HAW-Hatim/FPGA-Audio-Beamforming/Block diagrams/Address_counter.jpg

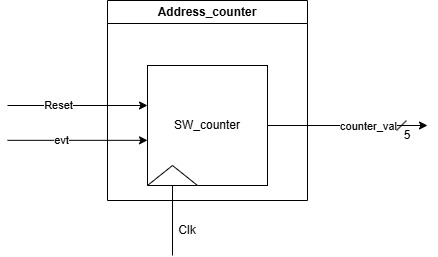
Block diagrams/Address_counter.jpg
