HAW-Hatim/FPGA-Audio-Beamforming/Block diagrams/Angle_To_Delay (1).jpg

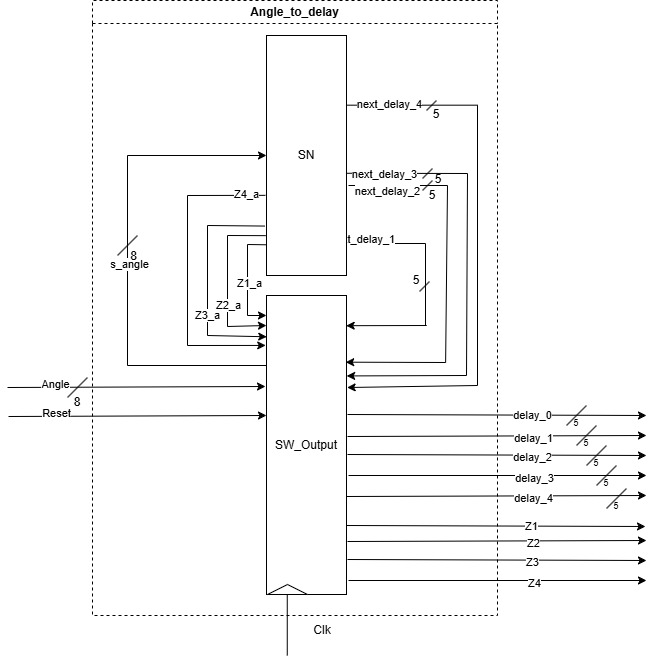
Block diagrams/Angle_To_Delay (1).jpg
