HAW-Hatim/FPGA-Audio-Beamforming/Block diagrams/Angle_To_Delay.jpg

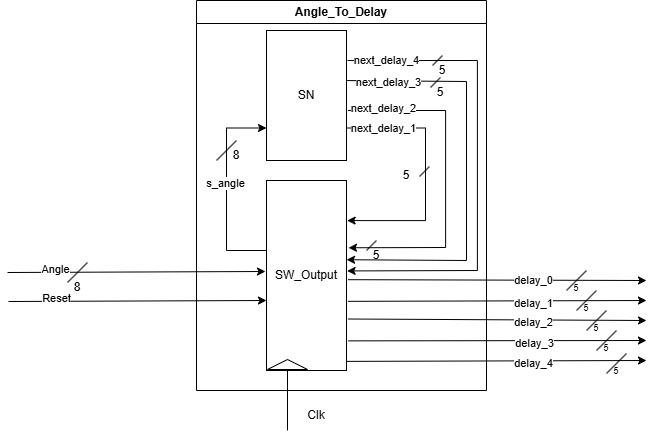
Block diagrams/Angle_To_Delay.jpg
