HAW-Hatim/FPGA-Audio-Beamforming/Block diagrams/BRAM (2).jpg

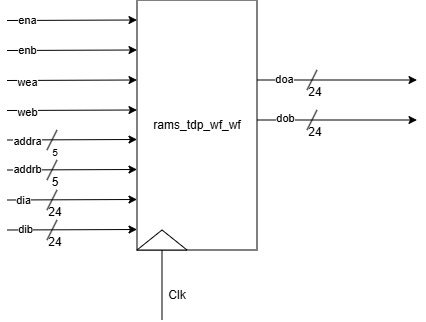
Block diagrams/BRAM (2).jpg
