HAW-Hatim/FPGA-Audio-Beamforming/Block diagrams/DAS_Blockdiagram (2).jpg

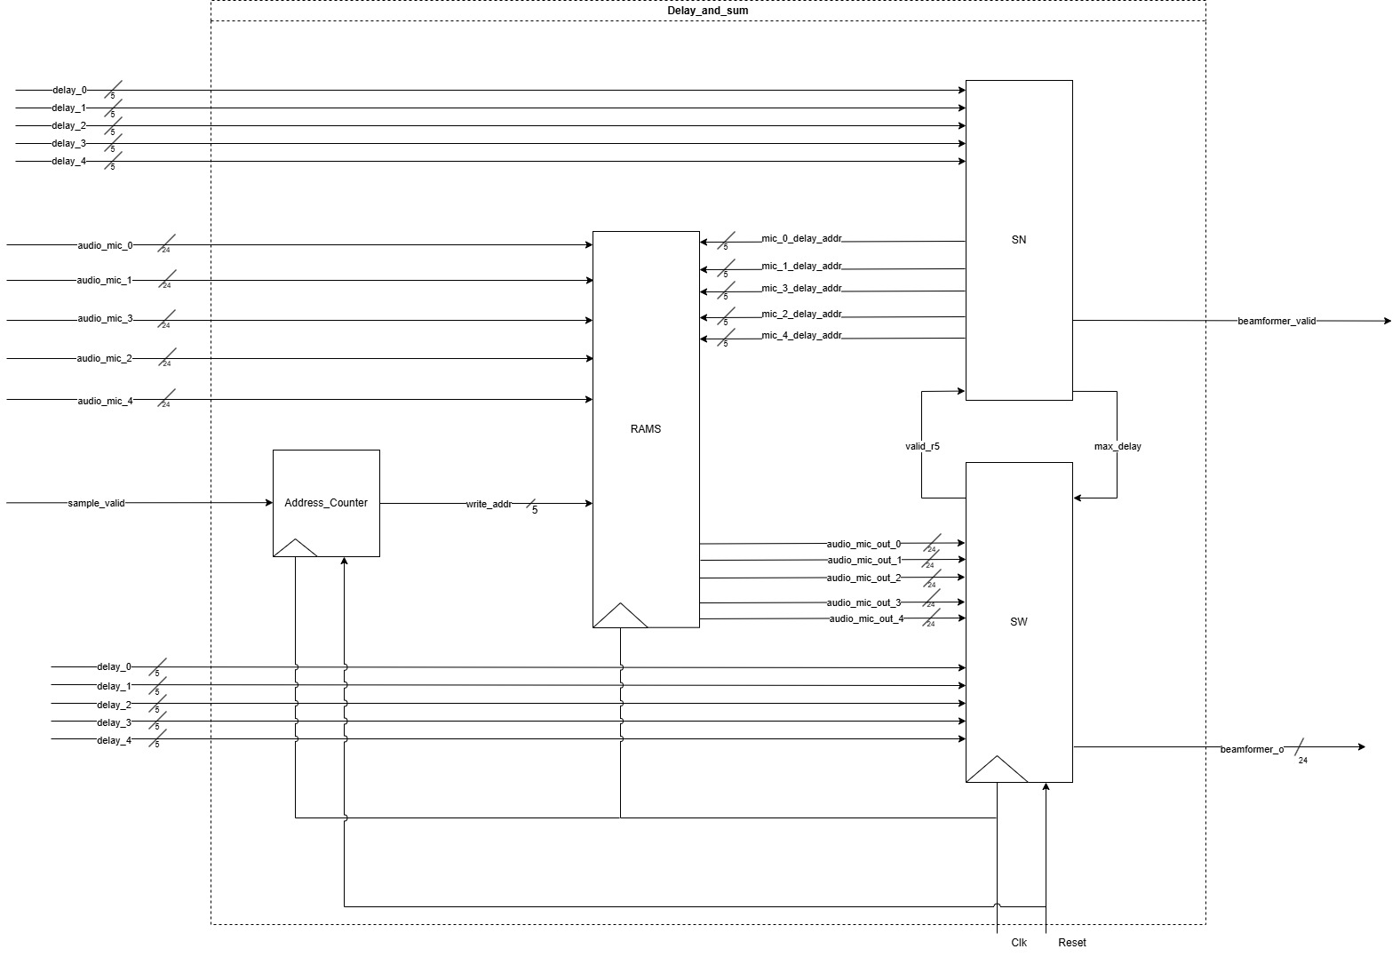
Block diagrams/DAS_Blockdiagram (2).jpg
