HAW-Hatim/FPGA-Audio-Beamforming/Block diagrams/DY_Final (1)-Seite-6.jpg

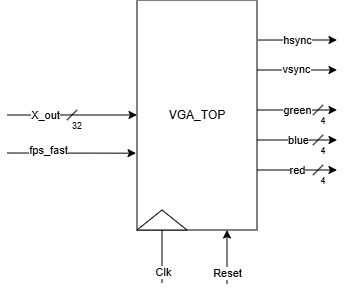
Block diagrams/DY_Final (1)-Seite-6.jpg
