HAW-Hatim/FPGA-Audio-Beamforming/Block diagrams/DY_Final-FFT32.jpg

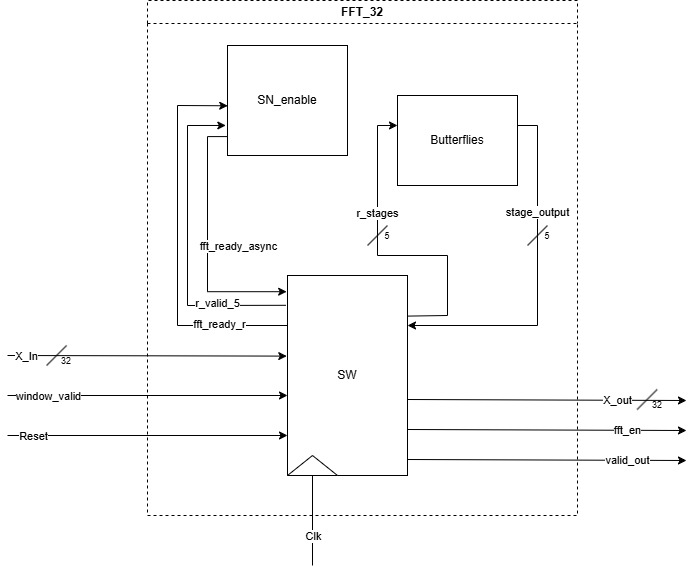
Block diagrams/DY_Final-FFT32.jpg
