HAW-Hatim/FPGA-Audio-Beamforming/Block diagrams/DY_Final-FFT_TOP.jpg

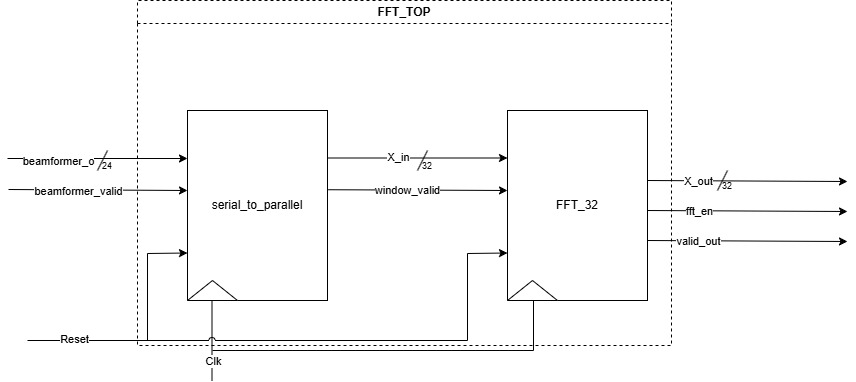
Block diagrams/DY_Final-FFT_TOP.jpg
