HAW-Hatim/FPGA-Audio-Beamforming/Block diagrams/DY_Final-FSM_S2p (1).jpg

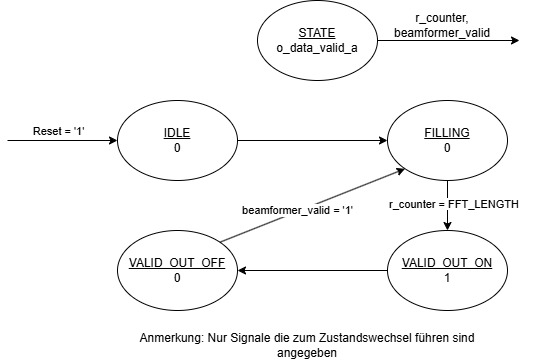
Block diagrams/DY_Final-FSM_S2p (1).jpg
