HAW-Hatim/FPGA-Audio-Beamforming/Block diagrams/DY_Final-S2P.jpg

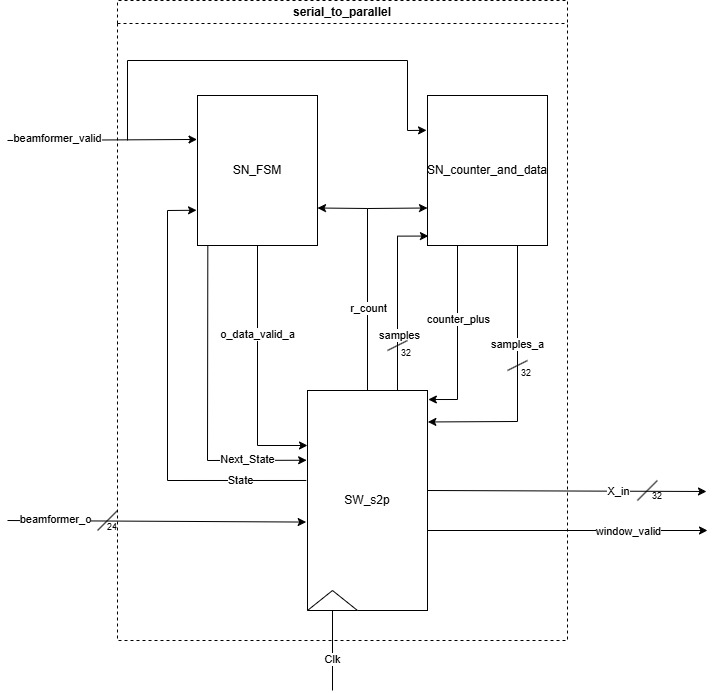
Block diagrams/DY_Final-S2P.jpg
