HAW-Hatim/FPGA-Audio-Beamforming/Block diagrams/i2s_rx.png

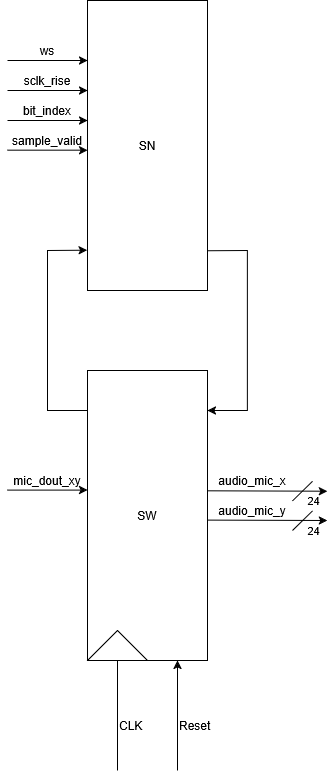
Block diagrams/i2s_rx.png
