HAW-Hatim/FPGA-Audio-Beamforming/Block diagrams/i2s_timing.png

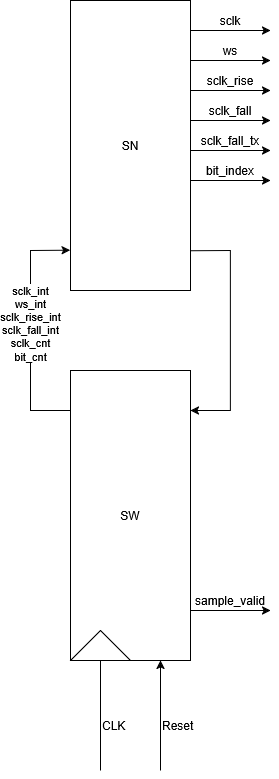
Block diagrams/i2s_timing.png
