HAW-Hatim/FPGA-Audio-Beamforming/Block diagrams/i2s_top.png

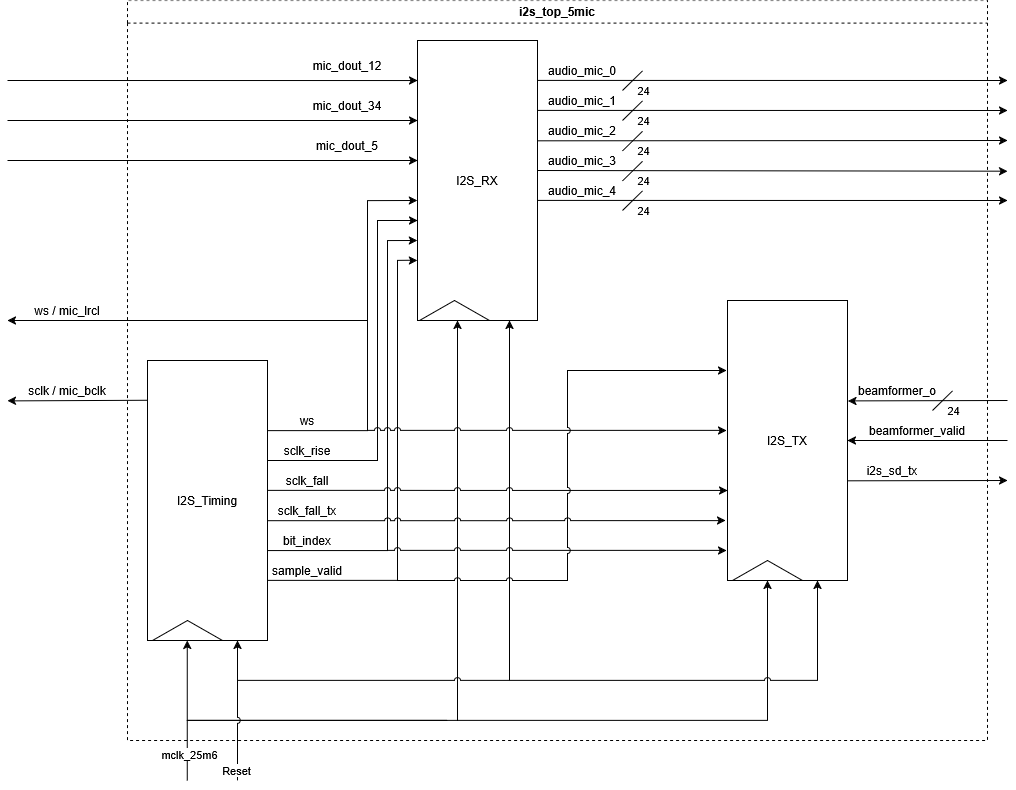
Block diagrams/i2s_top.png
