HAW-Hatim/FPGA-Audio-Beamforming/Block diagrams/i2s_tx.png

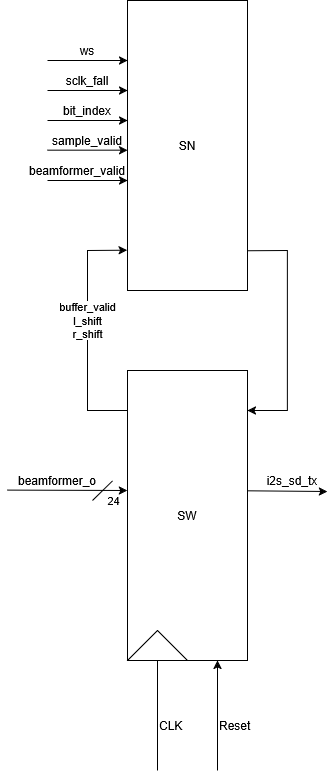
Block diagrams/i2s_tx.png
