HAW-Hatim/FPGA-Audio-Beamforming/Block diagrams/RAMS_Blockdiagram (3).jpg

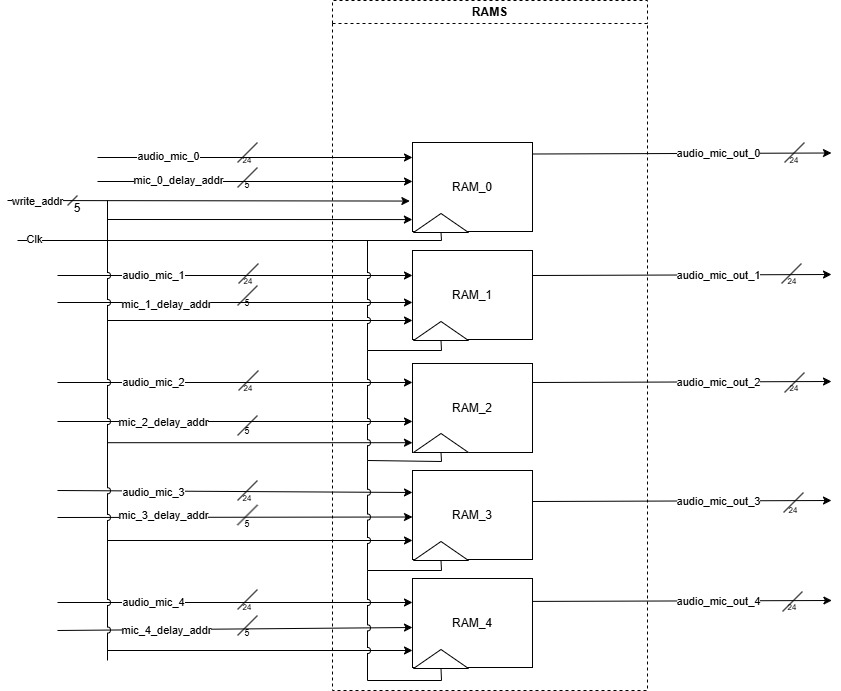
Block diagrams/RAMS_Blockdiagram (3).jpg
