HAW-Hatim/FPGA-Audio-Beamforming/Block diagrams/Seven_segment_disp.png

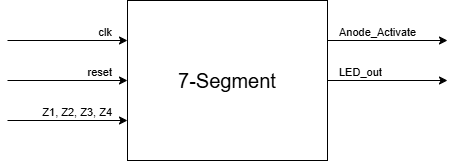
Block diagrams/Seven_segment_disp.png
