HAW-Hatim/FPGA-Audio-Beamforming/Results/1_5khz_30cm_90deg_to_minus90deg.jpg

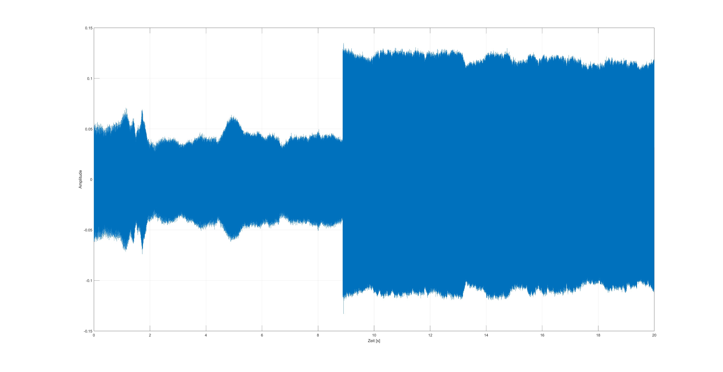
Results/1_5khz_30cm_90deg_to_minus90deg.jpg
