HAW-Hatim/FPGA-Audio-Beamforming/Results/1_5khz_30cm_minus90deg_to_0deg.jpg

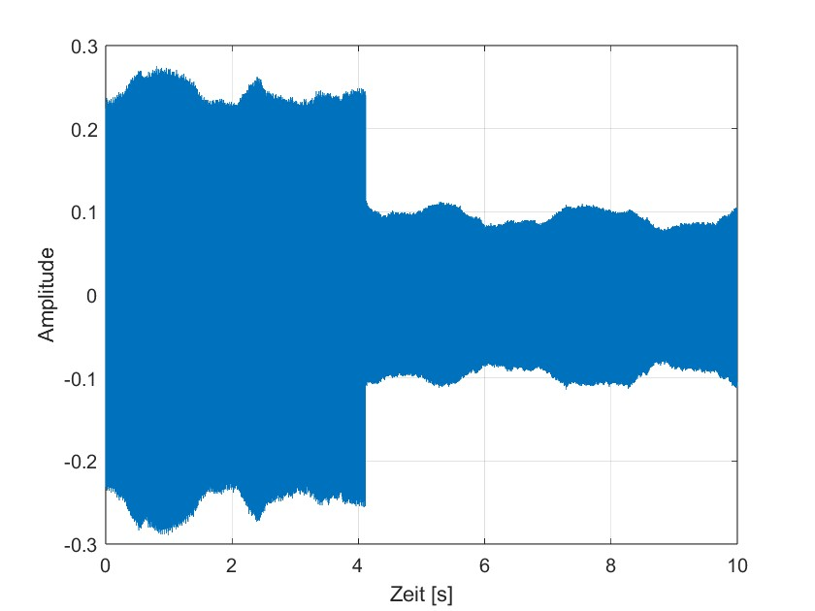
Results/1_5khz_30cm_minus90deg_to_0deg.jpg
