HAW-Hatim/FPGA-Audio-Beamforming/Results/4khz_30cm_90deg_to_minus90deg.jpg

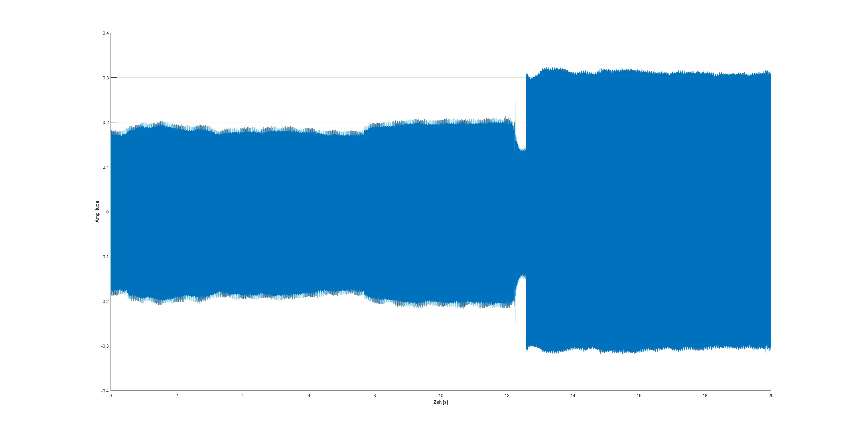
Results/4khz_30cm_90deg_to_minus90deg.jpg
