HAW-Hatim/FPGA-Audio-Beamforming/Results/Simulation/Simu_All.jpg

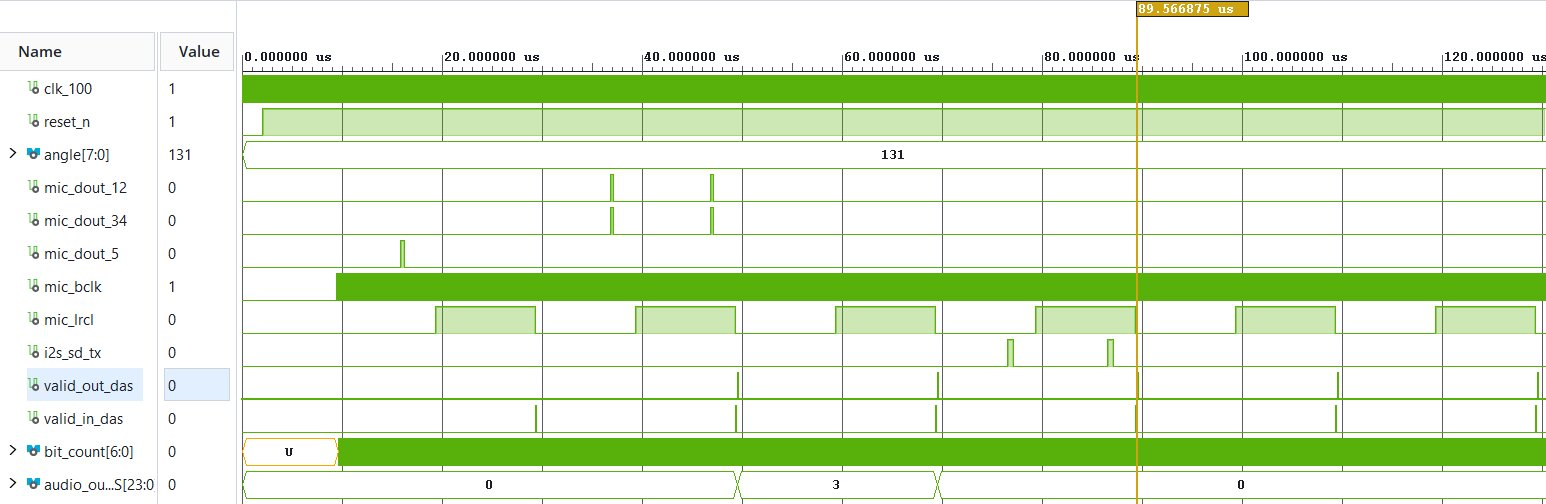
Results/Simulation/Simu_All.jpg
