HAW-Hatim/FPGA-Audio-Beamforming/Results/Simulation/Simu_All.png

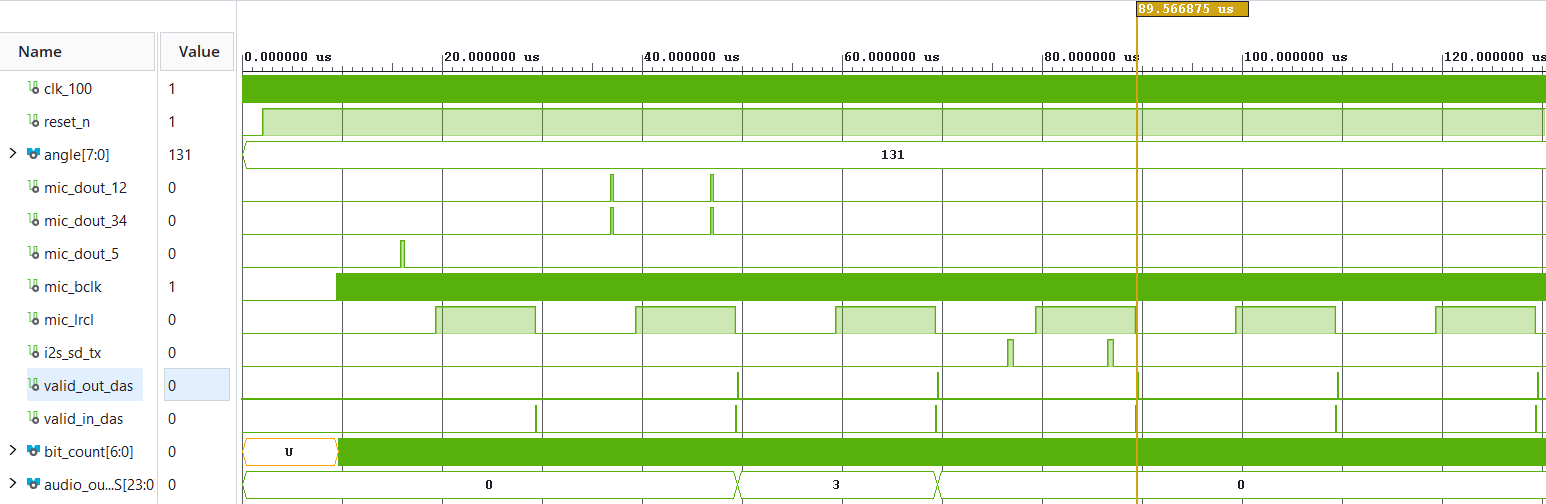
Results/Simulation/Simu_All.png
