HAW-Hatim/FPGA-Audio-Beamforming/Results/Simulation/simu_valid_behavior.png

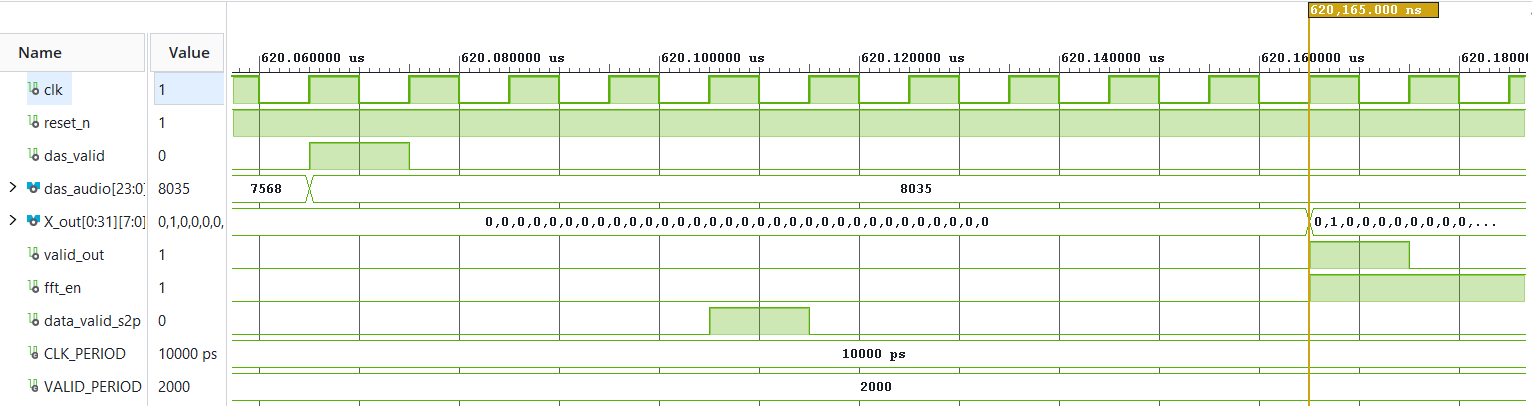
Results/Simulation/simu_valid_behavior.png
