HAW-Hatim/FPGA-Audio-Beamforming/Results/Simulation/Valid_out.png

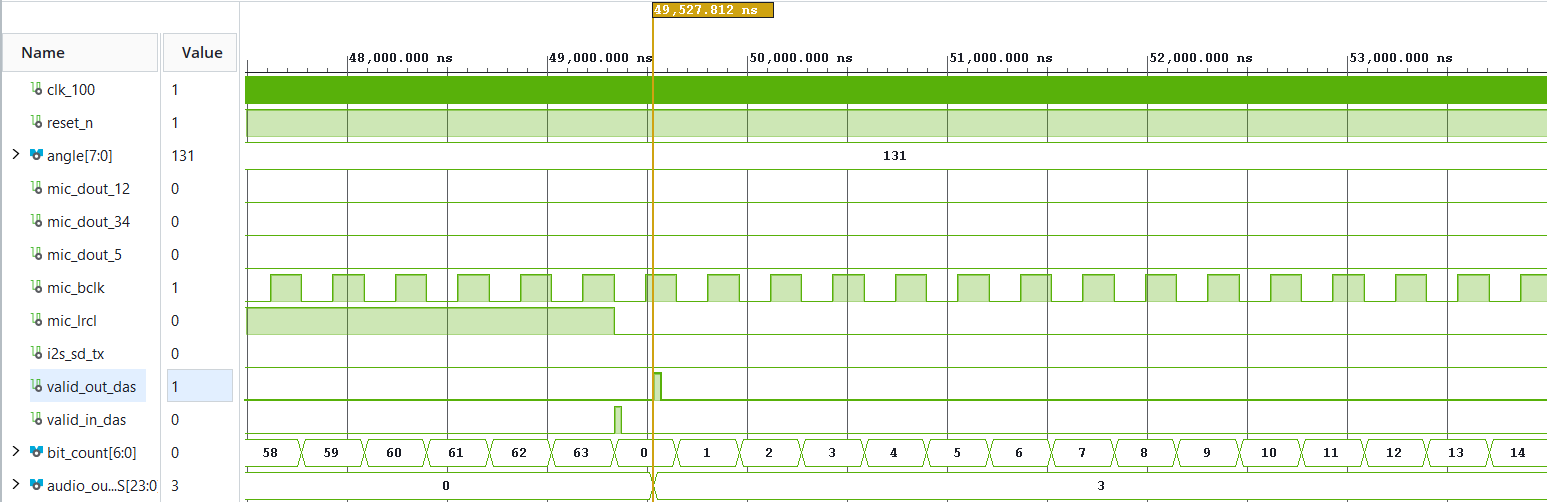
Results/Simulation/Valid_out.png
