HAW-Hatim/FPGA-Audio-Beamforming/Sources/new/Angle_to_delay.vhd

library IEEE;
use IEEE.STD_LOGIC_1164.ALL;

-- Uncomment the following library declaration if using
-- arithmetic functions with Signed or Unsigned values
use IEEE.NUMERIC_STD.ALL;

-- Uncomment the following library declaration if instantiating
-- any Xilinx leaf cells in this code.
--library UNISIM;
--use UNISIM.VComponents.all;

entity Angle_to_delay is
    Port ( Clk : in STD_LOGIC;
           Angle : in STD_LOGIC_VECTOR (7 downto 0);
           delay_0 : out STD_LOGIC_VECTOR (4 downto 0);
           delay_1 : out STD_LOGIC_VECTOR (4 downto 0);
           delay_2 : out STD_LOGIC_VECTOR (4 downto 0);
           delay_3 : out STD_LOGIC_VECTOR (4 downto 0);
           delay_4 : out STD_LOGIC_VECTOR (4 downto 0);
           Z1 : out INTEGER range 0 to 11; -- Tausenderstelle
           Z2 : out INTEGER range 0 to 11; -- Sign;
           Z3 : out INTEGER range 0 to 11; -- Zehnerstelle
           Z4 : out INTEGER range 0 to 11; -- Einerstelle
           Reset_n : in STD_LOGIC);
end Angle_to_delay;

architecture Behavioral of Angle_to_delay is
signal ff1_angle, s_angle: std_logic_vector(7 downto 0);
signal next_delay_1,next_delay_2,next_delay_3,next_delay_4: std_logic_vector(4 downto 0);
signal  Z1_a, Z2_a, Z3_a, Z4_a: INTEGER range 0 to 11;



begin
Sw_Output: process(Clk, Reset_n)

begin
    if Reset_n = '0' then
            delay_0 <= (others => '0'); 
            delay_1 <= (others => '0'); 
            delay_2 <= (others => '0'); 
            delay_3 <= (others => '0'); 
            delay_4 <= (others => '0'); 
    
    elsif rising_edge(Clk) then
    
        --Synchronisation of input 2FF
        ff1_angle <= Angle;
        s_angle <= ff1_angle;
            
        -- Depending on if we come from left or right one is our reference microphone
        -- Positive angle means index 0 is reached first by the sound wave hence needing to be delayed
        -- the most time
        if s_angle(7) = '0' then
            delay_4 <= (others => '0');
            delay_3 <= next_delay_1;
            delay_2 <= next_delay_2;
            delay_1 <= next_delay_3;
            delay_0 <= next_delay_4;
            
            Z2 <= 11;
        else
            delay_4 <= next_delay_4;
            delay_3 <= next_delay_3;
            delay_2 <= next_delay_2;
            delay_1 <= next_delay_1;
            delay_0 <= (others => '0');
            
            Z2 <= 10;
        
        end if;  
        Z1 <= Z1_a;
        --Z2 <= Z2_a;
        Z3 <= Z3_a;
        Z4 <= Z4_a;
    end if;
end process;

SN_Delays: process(s_angle)

begin

-- default
next_delay_4 <= (others => '0');
        next_delay_3 <= (others => '0');
        next_delay_2 <= (others => '0');
        next_delay_1 <= (others => '0');
        Z1_a <= 11;
        Z2_a <= 11;
        Z3_a <= 0;
        Z4_a <= 0;


case s_angle(6 downto 0) is
     -- Angle 90
    when "1011010" =>
        next_delay_4 <= std_logic_vector(TO_UNSIGNED(23,5));
        next_delay_3 <= std_logic_vector(TO_UNSIGNED(17,5));
        next_delay_2 <= std_logic_vector(TO_UNSIGNED(11,5));
        next_delay_1 <= std_logic_vector(TO_UNSIGNED(5,5));
        Z3_a <= 9;
        Z4_a <= 0;
    -- Angle 89
    when "1011001" =>
        next_delay_4 <= std_logic_vector(TO_UNSIGNED(23,5));
        next_delay_3 <= std_logic_vector(TO_UNSIGNED(17,5));
        next_delay_2 <= std_logic_vector(TO_UNSIGNED(11,5));
        next_delay_1 <= std_logic_vector(TO_UNSIGNED(5,5));
        Z3_a <= 8;
        Z4_a <= 9;
    -- Angle 88
    when "1011000" =>
        next_delay_4 <= std_logic_vector(TO_UNSIGNED(23,5));
        next_delay_3 <= std_logic_vector(TO_UNSIGNED(17,5));
        next_delay_2 <= std_logic_vector(TO_UNSIGNED(11,5));
        next_delay_1 <= std_logic_vector(TO_UNSIGNED(5,5));
        Z3_a <= 8;
        Z4_a <= 8;
    -- Angle 87
    when "1010111" =>
        next_delay_4 <= std_logic_vector(TO_UNSIGNED(23,5));
        next_delay_3 <= std_logic_vector(TO_UNSIGNED(17,5));
        next_delay_2 <= std_logic_vector(TO_UNSIGNED(11,5));
        next_delay_1 <= std_logic_vector(TO_UNSIGNED(5,5));
        Z3_a <= 8;
        Z4_a <= 7;
    -- Angle 86
    when "1010110" =>
        next_delay_4 <= std_logic_vector(TO_UNSIGNED(23,5));
        next_delay_3 <= std_logic_vector(TO_UNSIGNED(17,5));
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
        next_delay_4 <= std_logic_vector(TO_UNSIGNED(0,5));
        next_delay_3 <= std_logic_vector(TO_UNSIGNED(0,5));
        next_delay_2 <= std_logic_vector(TO_UNSIGNED(0,5));
        next_delay_1 <= std_logic_vector(TO_UNSIGNED(0,5));
end case;
    
end process;
end Behavioral;
